annahudson356/lidar-sensor-hardware-hack-2026/3D Printed Parts/Base Gears Servo Mount Assembly.stl

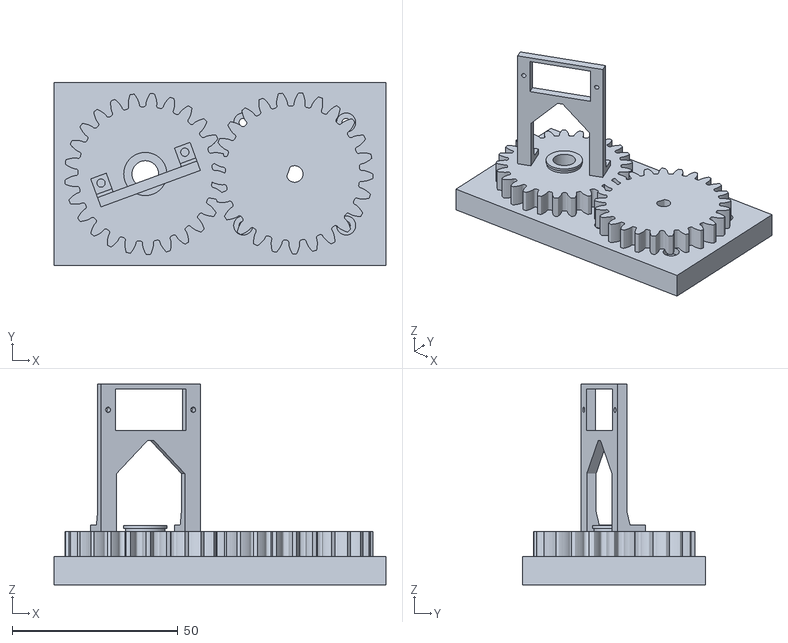
[picture p1: CAD file, 2026-03-29]
3D Printed Parts/Base Gears Servo Mount Assembly.stl
100.0 x 55.0 x 60.4
