annahudson356/lidar-sensor-hardware-hack-2026/3D Printed Parts/LiDAR Mount.stl

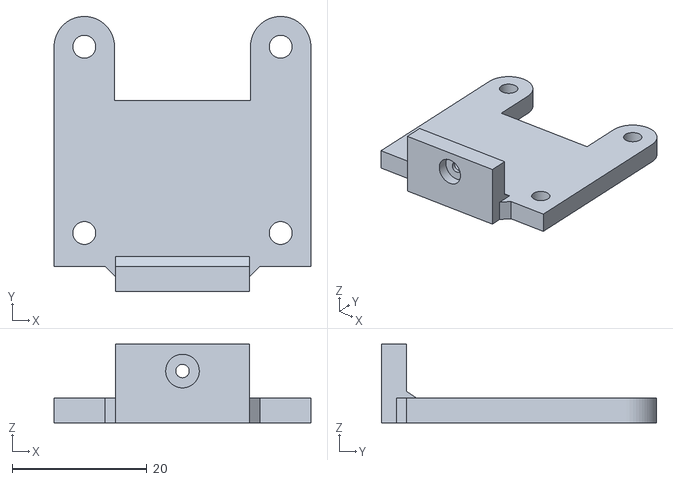
[picture p2: CAD file, 2026-03-29]
3D Printed Parts/LiDAR Mount.stl
38.2 x 40.9 x 11.7
