annahudson356/lidar-sensor-hardware-hack-2026/3D Printed Parts/Base.stl

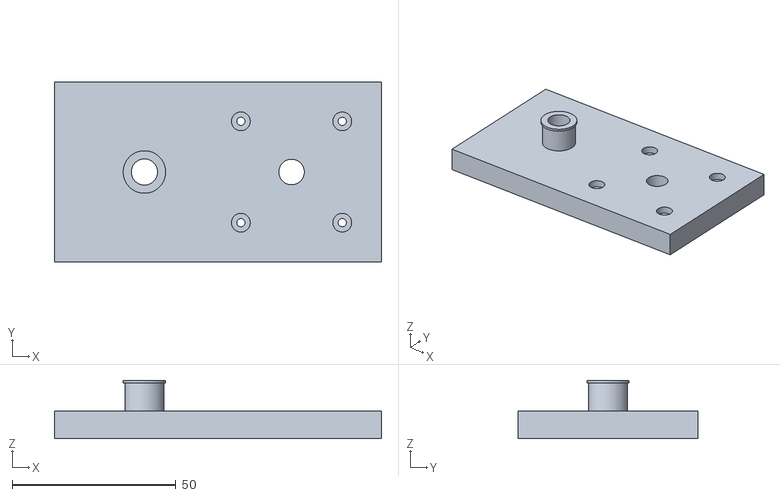
[picture p3: CAD file, 2026-03-29]
3D Printed Parts/Base.stl
100.0 x 55.0 x 17.8
