annahudson356/lidar-sensor-hardware-hack-2026/3D Printed Parts/Servo Mount Gear.stl

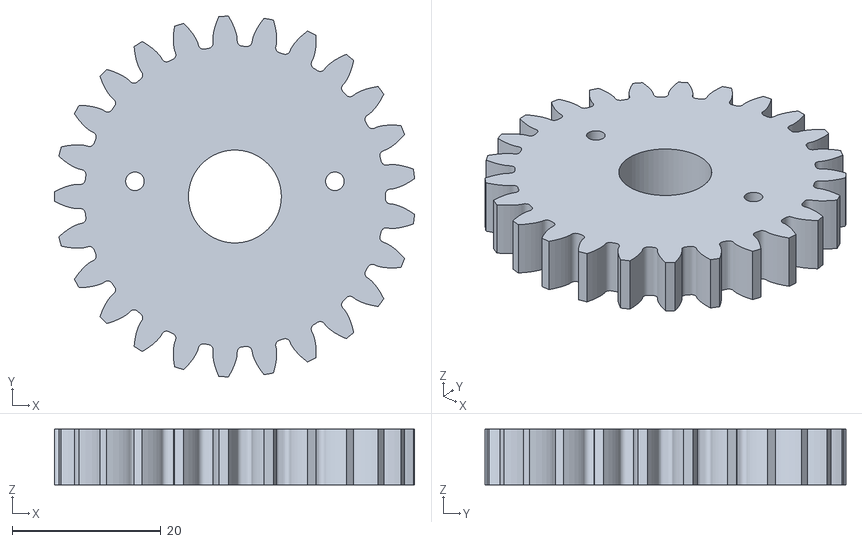
[picture p4: CAD file, 2026-03-29]
3D Printed Parts/Servo Mount Gear.stl
48.5 x 48.6 x 7.50
