annahudson356/lidar-sensor-hardware-hack-2026/3D Printed Parts/Motor Gear.stl

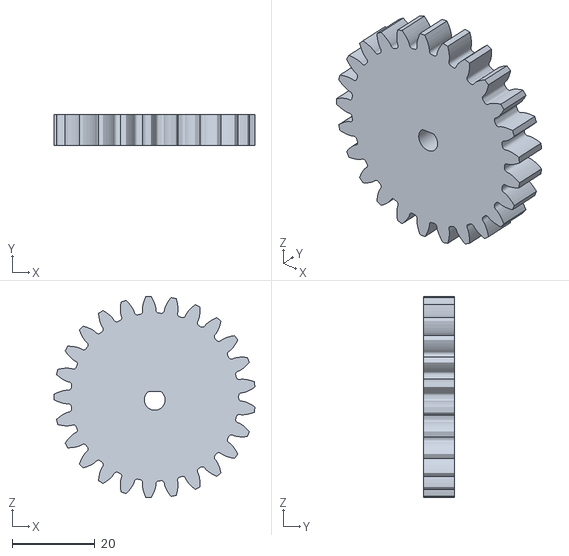
[picture p5: CAD file, 2026-03-29]
3D Printed Parts/Motor Gear.stl
48.5 x 7.50 x 48.6
