annahudson356/lidar-sensor-hardware-hack-2026/3D Printed Parts/Servo Mount.stl

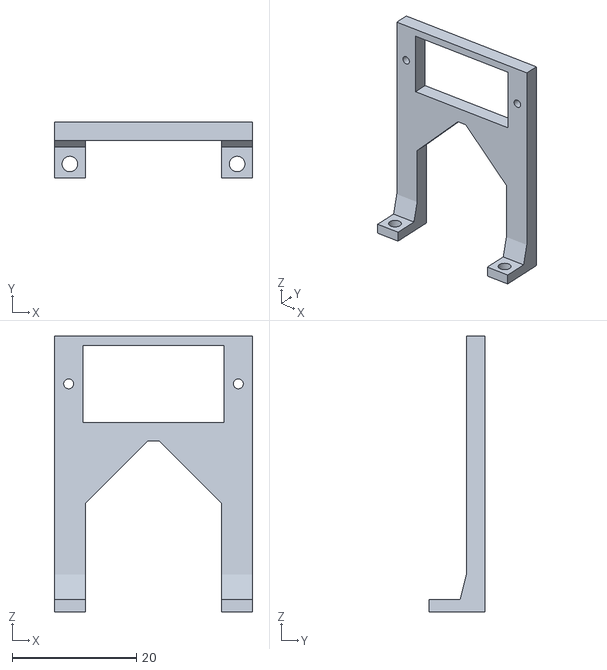
[picture p6: CAD file, 2026-03-29]
3D Printed Parts/Servo Mount.stl
31.9 x 9.00 x 44.4
