annahudson356/lidar-sensor-hardware-hack-2026/(commit log)

2026-03-28 added stepper motor file
2026-03-28 Fixed wiring and set constant speed
    [stepper_motor.ino]
2026-03-28 Added servo file
2026-03-28 basic template for lidar
2026-03-28 Combined stepper and servo into a single program
2026-03-28 Removed nested servo folder
2026-03-28 Added basic LiDAR support
2026-03-28 Added bias correction and basic error recovery to LiDAR
    [toolbox.ino]
2026-03-28 Removed LiDAR error recovery because it didn't recover anything
    [toolbox.ino]
2026-03-29 Updated with correct output info for unity
    [toolbox.ino]
2026-03-29 CAD Files
    [Base Gears Servo Mount Assembly.stl, Base.stl, LiDAR Mount.stl, Motor Gear.stl, Servo Mount Gear.stl, Servo Mount.stl]
2026-03-29 file rename lol
    [Base Gears Servo Mount Assembly.stl, Base.stl, LiDAR Mount.stl, Motor Gear.stl, Servo Mount Gear.stl, Servo Mount.stl]
2026-03-29 Upped Motor Speed, fixed rendering
    [toolbox.ino]
